johnharveybc/Robert-roving-robot/Report/Robot Pictures/Chassis Front.jpg

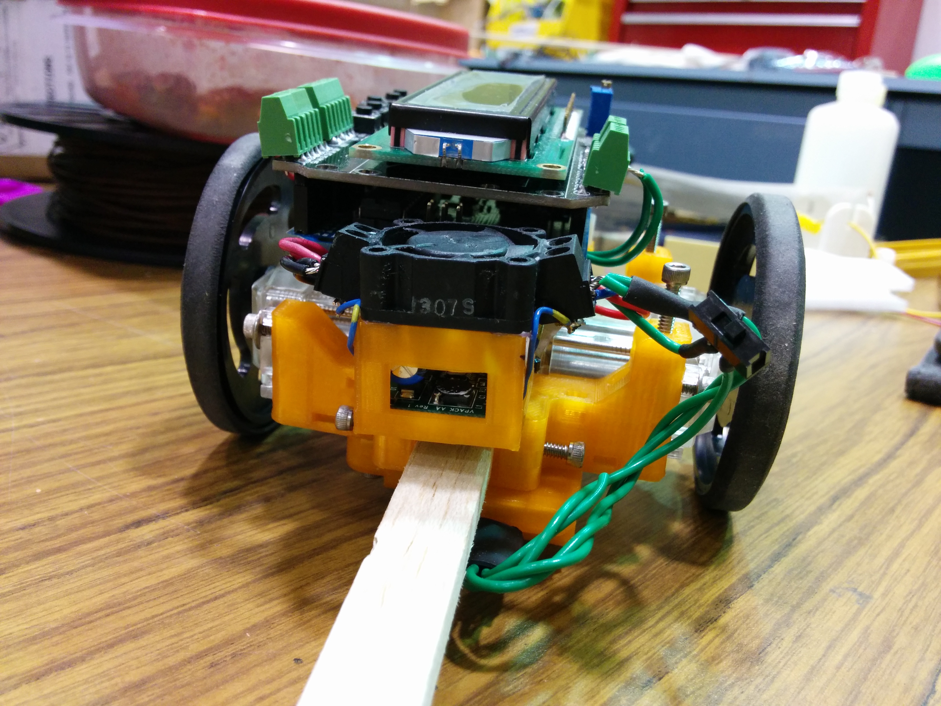
Report/Robot Pictures/Chassis Front.jpg
