johnharveybc/Robert-roving-robot/Report/Robot Pictures/Inductors.jpg

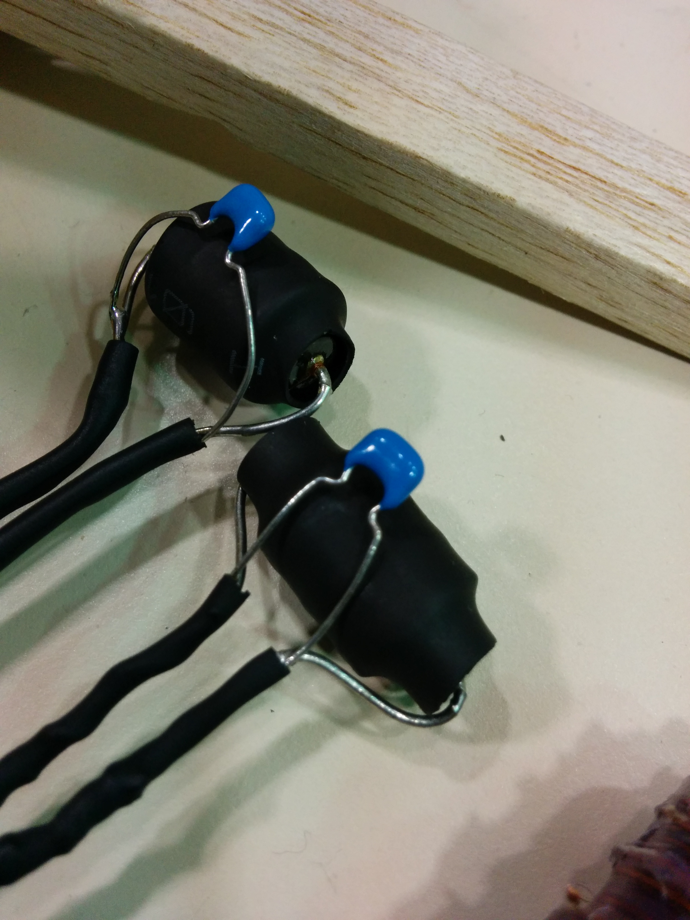
Report/Robot Pictures/Inductors.jpg
