johnharveybc/Robert-roving-robot/README.md

Robert-roving-robot
===================

EECE 284 January-April 2014
