johnharveybc/Robert-roving-robot/Report/EECE 284 report.docx

EECE 284: Electronics Laboratory

Project Report for Fast Orange—an Electromagnetic Track Rover

John Harvey, 29240116 (25%)

Liam Hodgson, 29154119 (25%)

Scott Lawson, 34359117 (25%)

Rowan Walsh, 30817118 (25%)

March 31st, 2014

Course taught by Dr. Jesús Calviño-Fraga, P. Eng

# 1.0—Introduction

Our project for EECE 284 was an Arduino-based rover, designed to follow a sinusoidal, 15.175 kHz electromagnetic signal. The format of the course was a time trial: each group’s robot completed a circuit of a racetrack. The runs were timed, and after each group’s entry attempted the course, the robot with the fastest time was awarded the highest mark.

The signal the robot was to follow was generated by running a 20V peak-to-peak 15.175 kHz sinusoidal voltage through a wire. The wire was embedded in the competition surface, creating the path the robots were to follow. In addition to straight track, signals were placed along the track, indicating the beginning and end of the path, as well as the direction to turn at the intersection of wires. Bridges were another feature of the track, which added an extra challenge, as robots could not vary their path too greatly while on the bridge, for risk of falling off, and as the depth of the wire from the surface was greater on the bridges.

The robot followed the racecourse by detecting the electromagnetic field generated by the wire, using inductors mounted at the front of the robot. These signals were put through peak-detection and amplification circuits, and then fed into a PID algorithm. The outputs of the PID algorithm drove MOSFET motor drivers, allowing the robot to follow the wire and racecourse with a high degree of accuracy.

## 1.1—Mechanical

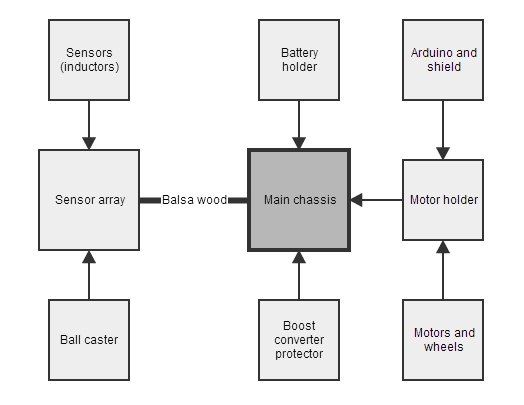
[picture p3: figure]

The chassis, the main mechanical component of the robot, was designed to minimize mass and structurally incorporate as many essential components (microcontroller, motors, battery) as possible. The robot consisted of three sections: the main chassis, sensor array, and a piece of balsa wood which joined the two. The front chassis and sensor array were 3D printed in bright orange poly-lactic acid (PLA), to minimize mass, and in homage to the industrial-strength, orange-scented hand cleaner, Fast Orange.

Figure 1: Mechanical block diagram

The main chassis consisted of three components: a battery holder, boost-converter protector, and motor holder. The battery used fit neatly under the robot, as it was flat and thin. Four short wires extended from the battery holder to the boost-converter protector, mounted at the front of the main chassis. Wires carrying 5 and 10 volts left the boost converter, carrying power to the Arduino Uno and motors, respectively. A shield incorporating an LCD monitor, potentiometers, several screw-terminal ports, and six buttons sat atop the Arduino Uno, which was mounted on the motor holder. Unsurprisingly, the motor holder held the motors. The other components (boost-converter protector, battery holder, balsa wood) were attached to the motor holder.

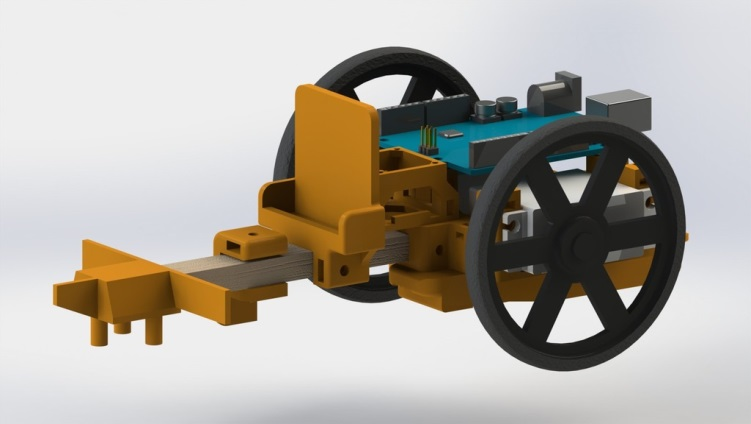
[picture p4: figure]

The sensor array held a Tamiya 70144 ball caster and three inductors—two perpendicular to the direction of motion of the robot, one parallel, and all mounted close to the ground. The balsa wood was firmly inserted in the sensor array, holding it in front of the main chassis.

Figure 2: A Solidworks render of the rover. Not pictured: sensors, ball caster, shield, or amplifier circuits.

Various nuts, bolts, plastic spacers, and some hot glue held the components together.

## 1.2—Electrical

### 1.2.1—Power supply

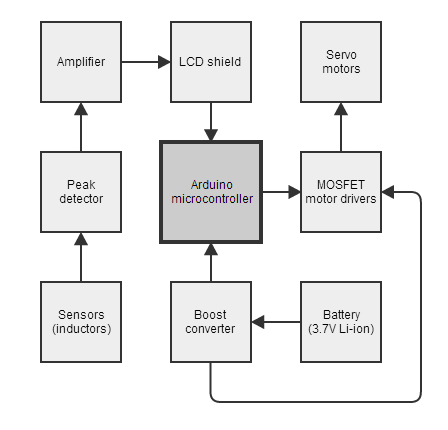
[picture p5: figure]

The choice of power supply for our robot was important, as a higher voltage would allow us to run the motors at a higher RPM, and a larger capacity would allow for longer testing time. The battery chosen, a rechargeable lithium ion battery with a voltage of 3.7 volts and a capacity of 950 mAh [1] was taken from an old cellphone. Quick to recharge and lightweight, the battery fell well below the limit set for this competition. To provide an appropriate voltage for the Arduino and motors, a DC-DC boost converter was used, allowing us to supply 10V to the motors, and 5V to the Arduino, without surpassing the maximum battery voltage of 6V. An appropriate choice of battery to work with the boost converter was important: a battery with an extremely low internal resistance had to be used to supply sufficient current to the converter, ruling out traditional alkaline batteries. Additionally, by using a boost converter, we were able to ensure that the motor voltage did not fluctuate as the battery drained, allowing for more repeatability in testing.

Figure 3: Electrical block diagram

The converter used was a VPack PBC [2] based on an LM2623MM DC/DC boost converter, modified to supply ten and five volts. Said modification consisted of de-soldering and replacing a pair of surface-mount resistors and capacitors. The battery came from an LG Rumour 2.

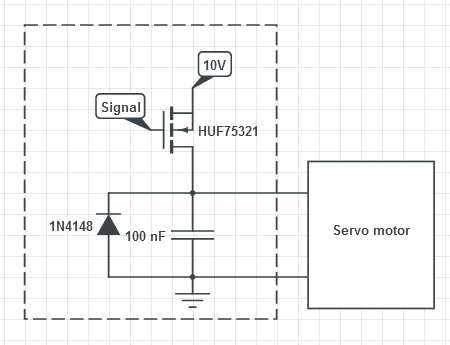
[picture p6: figure]

### 1.2.2—Motor control

Figure 4: MOSFET motor controller

The two Solarbotics GM4 servos provided the driving force for the robot, and were controlled via MOSFET drivers. The gate of the MOSFET was connected to the PWM output of the Arduino, and the source and drain were connected to the 10V supplied by the boost converter and the motor, respectively. A diode and capacitor were used with the motor controller to prevent flyback current and serve as a decoupling capacitor.

### 1.2.3—Sensor array

The robot was to follow a path defined by a buried wire carrying a 20V peak-to-peak signal at 15.175 kHz. This magnetic field produced by the wire was detected by two 100mH inductors. By placing appropriately-sized capacitors ( C=1/4π^2 f^2 L ) in parallel with the inductors, the sensors could be tuned to a resonant frequency equal to that of the desired field. 1nF capacitors were selected, producing a resonant frequency of 15.9kHz, which was sufficiently close to the desired frequency to be effective.

Two inductors were mounted perpendicular to the direction of motion, to provide relative signal strength, indicating whether the robot was to the left or right of the path. One inductor was mounted parallel to the direction of motion, to detect wire perpendicular to the track, indicating the start, end, and turn warnings on the track. These inductors were mounted closer to the bulk of the robot than the other sensors—the further away the perpendicular sensors were from the main chassis, the more sensitive they would be to small changes in the angle of the robot. By placing the parallel sensor close to the main chassis, turns could be detected later, reducing the delay between detection of a turn and the turn itself.

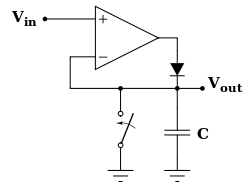
[picture p7: figure]

The AC signal induced in the inductor was then converted to DC via a peak detector, and amplified by a fixed-gain amplifier with a gain of approximately x20. The structure of the peak detector was a BJT (acting as a switch) connected to a digital output port, wired in parallel with a capacitor. A diode rectified the input voltage, which charged the capacitor to the peak voltage of the signal. This voltage was read by one of the digital inputs on the Arduino. After reading, the gate of the BJT shorts to ground, discharging the capacitor and restarting the process. A non-inverting amplifier circuit, consisting of an op-amp and several resistors, was used to provide variable gain.

Figure 5: Peak-detector circuit diagram

### 1.2.4—Microcontroller

An Arduino UNO microcontroller was chosen for the controller of our robot, as team members were more familiar with it than the provided microcontroller. Sufficiently powerful, reasonably inexpensive, and with a wealth of libraries, the Arduino read the sensors, controlled the motors voltage, displayed information on the LCD, and ran the PID algorithm on the sensor inputs. The Arduino was never directly interfaced with: all inputs and outputs went through a shield.

### 1.2.5—LCD shield

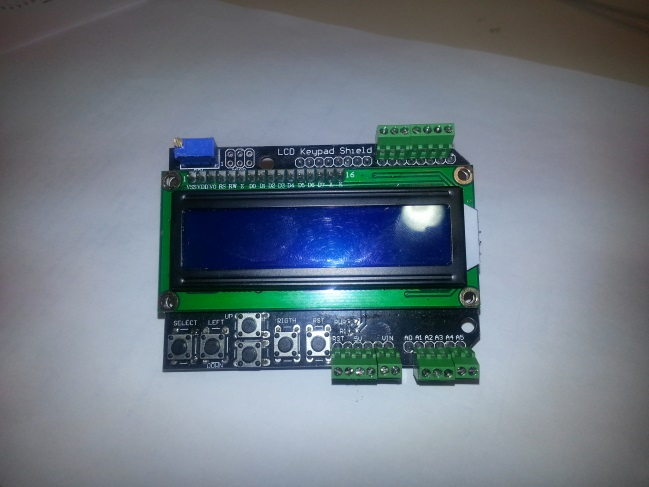
[picture p8: figure]

An LCD shield [3] incorporating several buttons and a potentiometer was used to provide an easy interface for debugging and tuning the robot. Menus were navigated and software parameters (PID gain values, turn time, etc.) could be adjusted via the buttons. While the robot was running the course, the LCD displayed the battery voltage, time since beginning the run, and whether or not the robot had detected a turn. The screw-terminals on the shield proved very useful for making quick adjustments to circuitry and wiring.

Figure 6: The LCD shield

## 1.3—Software

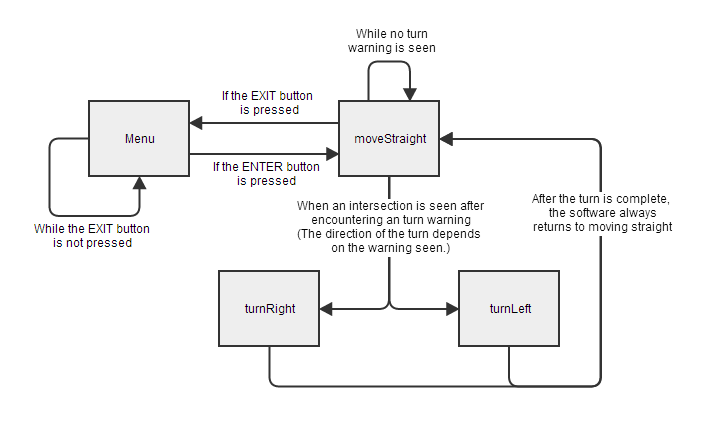
[picture p9: figure]

The robot's behaviour was coded as a loop with a simple state-space. In any distinct loop, the robot was in one of four states: Menu, MoveStraight, TurnRight, and TurnLeft. From the MoveStraight state, the Menu state was entered if the menu-entry button was pressed; likewise the Menu state could be exited to the MoveStraight state if the menu-exit button was pressed. The Menu state allowed the programming of various calibration values used by the robot: constants for the PID control, triggers and cut-offs, speeds, etc. The MoveStraight state was the main running state of the robot. Every loop in this state the sensors were read and fed to the PID control, which in turn controlled the PWM signals sent to the motors. The MoveStraight state also kept track of lap timing and intersection/signal counting. After encountering 2 or 3 closely-spaced intersections (which indicates an upcoming left or right turn), the intersection-handling block would change a flag on so that on the next intersection detection the robot would switch to the TurnLeft or TurnRight state. After executing either of the Turn states, the robot would return to MoveStraight, with the upcoming turn flag turned back off.

1.3.1—PID control
A PID (proportional, integral and derivative gain) control system was implemented to control the motion of the robot due to its simplicity. The difference between the two main inductors was used as the input error on which the PID gains were applied. To keep the speed of the robot high, the motor control was 'subtractive': both motors were run at the set maximum speed, with the PID algorithm's output subtracted from one of the motor's speeds instead of added. The sign of the output determined which motor was slowed to effect the correction.
We found that derivative gain had little to no effect on the robot's performance, likely because of the low speeds used. Higher integral gains prevented the robot from 'falling off' while turning tight corners and prevented any steady-state errors on straight sections of the track. The running integral 'sum' of past errors was capped and also reset whenever the robot turned at an intersection.

1.3.2—Signals and intersections
The value of the center, intersection, inductor is read every loop while the robot is in the moveStraight state. The analog value read by the sensor circuit is evaluated to a digital 'high' (intersection detected) or 'low' (no intersection detected) using a Schmitt trigger in order to give some hysteresis to the signal and prevent oscillations close to the cut-off voltage. A Schmitt trigger has both a high-cut-off and low-cut-off such that Vhigh>Vlow. In order for the sensor's state to go high, its analog reading must exceed Vhigh; while for it to go low, its value must fall below Vlow. If the difference between the two cut-offs exceeds the typical noise from the sensor, then this trigger logic will act as a fairly stable rise-detector and provide an accurate count of the number of intersections passed.
As an intersection was passed, a running counter was incremented to indicate the number of recently-passed intersections. This counter has a timeout so that once the timeout is passed the count is stopped and used as the number of intersections in the recent turn signal 'block'. If this recent signal block had a count of just 1 (due to cross-talk from the main 'road' wire, etc.) it was ignored; counts of 2, 3, or 4 resulted in a flag to turn at the next intersection or stop the lap clock.

Figure 7: Software block diagram

# 2.0—Project analysis

## 2.1—Design analysis

While our robot performed well, several adjustments would be made if the project was undertaken again. Most importantly, the inductors would be more securely fastened. While it was easy to make fine adjustments to their positions, by bending the wires from which they hung, this created problems. The inductors were bumped around during transport of the robot, and in the occasional collision, which had dramatic effects on the robot’s ability to sense the line. Seemingly inconsequential adjustments proved to be the difference between successful and unsuccessful runs, and it was extremely difficult to quantify the adjustments made.

Using a cell phone battery was one of the better decisions made: in addition to allowing us to use a higher motor voltage, the size, ability to recharge, and weight proved advantageous. Teams, on average, went through 6-8 AA batteries. We used one battery, from an old cell phone, which was easier on the environment and pocketbook. We would likely reduce the motor voltage if the project was undertaken again: the robot ran at approximately a third of its top speed, as controlling the robot became extremely difficult after that point. A reduction in maximum speed would allow for more precise control over motor velocity.

Wire management became a concern later on in the project: last-minute additions lead to a large number of unruly wires, which came close to challenging the height requirements. Incorporating wire management into the chassis, or perhaps using piping in place of the balsa wood, and routing the wires through them, would be possibilities to explore.

One of the more successful debugging features incorporated were the ‘turn signals’. Two LEDs mounted near the front of the robot would blink before turns were initiated, allowing us to observe what the robot was sensing without having to observe whether or not it turned, and, on several occasions, allowing us to catch the robot before it turned off the table.

# 3.0—Conclusions

The robot ran very successfully—it completed the track without any human intervention with the fastest recorded time of any team: 1:09. By using a lighter battery and a 3D printed chassis, mass was significantly reduced, allowing for greater speed. Wiring became unruly as the project progressed, and the inductors were extremely vulnerable to changes in position—a small bump would result in unquantifiable motion of the inductors, changing the behaviour of the robot. Our choice of a rechargeable battery, with a DC-DC converter, ensured that the voltage the motors and Arduino saw would remain constant regardless of the charge level of the battery, increasing repeatability in testing.

The planning, design, coding, manufacture, and testing of the robot took approximately 100-120 hours in total. If the robot was to be constructed again, it is estimated that it would take no more than 20 hours—printing the parts, manufacturing the circuits, and adjusting the inductors would take the lion’s share of the time.

# References

If we referred to it in the body of the report (a book, website, source of information) we need to have the full citation here. The in-text citation should just be a number in square brackets, [n], and the references should look something like this:

[1] LG Electronics, “LG RUMOR 2 (LX265)”, http://www.lg.com/us/cell-phones/lg-LX265-Black-black-rumor-2

[2] Sparkfun Electronics, “5V DC to DC Step Up – Vpack PCB”, https://www.sparkfun.com/products/8290

[3] RobotShop Distribution Inc., “DFRobot LCD Keypad Shield for Arduino”, http://www.robotshop.com/en/dfrobot-lcd-keypad-shield-arduino.html

# Bibliography

Cockrill, C., “Understanding Schmitt Triggers”, September 2011, retrieved from http://www.ti.com/lit/an/scea046/scea046.pdf

Nave, R., “Resonant LRC Circuits”, December 2012, retrieved from http://hyperphysics.phy-astr.gsu.edu/hbase/electric/serres.html

Romani, M., “SimpleTimer – A timer library for Arduino”, 2010, retrieved from https://github.com/infomaniac50/SimpleTimer

Marziali, A. and Nakane, J., “ENPH 253 Labs and Lectures 2013”, May 2013, retrieved from http://projectlab.engphys.ubc.ca/coursearchive/enph253-2013/labslectures2013/

# Appendices

## Appendix 1: Code

#include <SimpleTimer.h> // Pre-built library

#include <LiquidCrystal.h> // Pre-built library

#include <EEPROM.h> // Pre-built library

LiquidCrystal lcd(8, 9, 4, 5, 6, 7);

// Configuration

#define SUBTRACTIVE_MOTOR_SPEED // Comment for additive and subtractive motor speed

#define CALCULATE_DERIVATIVE_ERROR // Comment to remove derivative gain from error calculations

#define CALCULATE_INTEGRAL_ERROR // Comment to remove integral gain from error calculations

#define CALCULATE_ANALOG_PID // Comment to calculate PID error using boolean logic instead

// of analog values

#define USE_SMART_INTERSECTIONS // Comment to use the intersection map instead of sensing intersection signals

//#define DEBUG_MODE // Comment to display voltage and time instead of debug

// values

// Pin definitions

#define LEFT_SENSOR 1 // ANALOG

#define RIGHT_SENSOR 2 // ANALOG

#define CENTER_SENSOR 3 // ANALOG

#define BATTERY_SENSOR 4 // ANALOG

#define BUTTON_INPUT 0 // ANALOG

#define LEFT_MOTOR 11 // PWM

#define RIGHT_MOTOR 3 // PWM

#define SENSOR_RESET 2 // DIGITAL

#define LEFT_TURN_LED 12 // DIGITAL

#define RIGHT_TURN_LED 13 // DIGITAL

// Keypad button definitions

#define RIGHT 0

#define UP 1

#define DOWN 2

#define LEFT 3

#define SELECT 4

#define NONE 5

// LCD cursor definitions

#define TOP 0

#define BOTTOM 1

// Wire States

#define TOO_LEFT -1

#define TOO_RIGHT 1

#define OFF_WIRE 5

// Turn indicator LEDs

SimpleTimer turnSignalTimer;

bool turnSignalState = false;

// "Clock" speed

unsigned long loopPeriod;

unsigned long lastLoop;

enum state

{

menu,

moveStraight,

turnLeft,

turnRight

};

struct Parameter

{

String Name;

byte Value;

int Index;

};

// Prevents LCD flicker

short lcdRefreshCount = 0;

short lcdRefreshPeriod = 200;

// Prevents excess battery readings

short batteryCount = 0;

short batteryPeriod = 10000;

volatile float batteryVoltage = 0.0;

// Sensors

volatile short left = 0;

volatile short right = 0;

volatile short leftDetected = false;

volatile short rightDetected = false;

// Smart intersection detection

#define INTERSECTION_COUNT_LEFT 2

#define INTERSECTION_COUNT_RIGHT 3

#define INTERSECTION_COUNT_ORIGIN 4

volatile short center = 0;

volatile short centerOldHigh = false;

volatile short intersectionSignalRecent = 0;

volatile short centerTimeoutCount = 0;

volatile short intersectionTurnFlag = 0;

// Mapped intersection detection

enum intersectionCommand

{

straight,

leftTurn,

rightTurn,

stop

};

int intersections[] =

{

straight,

straight,

straight,

straight,

straight,

leftTurn,

straight,

straight,

rightTurn,

straight,

straight,

};

#define INTERSECTION_COUNT (sizeof(intersections)/sizeof(int)) // MUST EQUAL NUMBER OF PARAMETERS

int intersectionIndex = -1;

volatile int centerNew = false;

volatile int centerRisingEdge = false;

volatile int centerHighDetected = false;

volatile int centerLowDetected = false;

// Control

float proportional = 0.0;

float integral = 0.0;

float derivative = 0.0;

short derivativeCounter = 0;

short integralOffsetPeriod = 50;

short integralOffsetCounter = integralOffsetPeriod;

float error = 0.0;

float previousError = 0.0;

// State tracking

state currentState = menu;

short menuIndex = 0;

// Clock

volatile unsigned int clockTime = 0;

volatile int clockRun = false;

volatile unsigned int clockStart = 0;

// EEPROM values

Parameter proportionalGain = {"P-gain", 0, 1};

Parameter integralGain = {"I-gain", 0, 2};

Parameter derivativeGain = {"D-gain", 0, 3};

Parameter speed = {"Speed", 0, 4};

Parameter thresholdLeft = {"L-Thresh", 0, 5};

Parameter thresholdRight = {"R-Thresh", 0, 6};

Parameter centerSchmittHigh = {"C-Schmitt H", 0, 7};

Parameter centerSchmittLow = {"C-Schmitt L", 0, 8};

Parameter integralCap = {"I-Cap", 0, 9};

Parameter centerTimeoutLimit = {"Timeout", 0, 10};

// Make sure any EEPROM value is added to the array

Parameter *parameters[] =

{

&proportionalGain, &integralGain, &derivativeGain,

&speed, &thresholdLeft, &thresholdRight, &centerSchmittHigh,

&centerSchmittLow, &integralCap, &centerTimeoutLimit

};

#define PARAMETER_COUNT (sizeof(parameters)/sizeof(Parameter*)) // MUST EQUAL NUMBER OF

// PARAMETERS

inline void TurnSignal()

{

if (intersectionTurnFlag == INTERSECTION_COUNT_LEFT)

{

digitalWrite(LEFT_TURN_LED, turnSignalState);

digitalWrite(RIGHT_TURN_LED, 0);

}

else if (intersectionTurnFlag == INTERSECTION_COUNT_RIGHT)

{

digitalWrite(LEFT_TURN_LED, 0);

digitalWrite(RIGHT_TURN_LED, turnSignalState);

}

else

{

digitalWrite(LEFT_TURN_LED, 0);

digitalWrite(RIGHT_TURN_LED, 0);

}

turnSignalState = !turnSignalState;

}

// Clears the LCD screen

inline void Clear()

{

lcd.clear();

}

// Prints a string to the LCD display, with an optional integer value beside it

inline void Print(String text, int value = -1)

{

lcd.print(text);

if (value != -1) lcd.print(value);

}

// Changes the LCD cursor location

inline void Cursor(int row, int column)

{

lcd.setCursor(column, row);

}

// SETUP

void setup()

{

// For algorithm speed checking

loopPeriod = 0;

lastLoop = micros();

// Initialize LCD

lcd.begin(16, 2);

lcd.setCursor(0,0);

pinMode(SENSOR_RESET, OUTPUT);

// Turn signals

pinMode(LEFT_TURN_LED, OUTPUT);

pinMode(RIGHT_TURN_LED, OUTPUT);

digitalWrite(LEFT_TURN_LED, 0);

digitalWrite(RIGHT_TURN_LED, 0);

turnSignalTimer.setInterval(100, TurnSignal);

// Force motors off by default

MotorSpeed(LEFT_MOTOR, 0);

MotorSpeed(RIGHT_MOTOR, 0);

// Parameters need to be loaded from EEPROM

LoadFromEEPROM();

// Intro text

Clear();

Cursor(TOP, 0);

Print("FAST ORANGE");

Cursor(BOTTOM, 0);

#ifdef DEBUG_MODE

Print("Debug Mode");

#else

Print("Race Mode");

#endif

delay(1000);

currentState = menu;

ClockReset();

}

// LOOP

void loop()

{

switch(currentState)

{

case menu:

MotorSpeed(LEFT_MOTOR, 0);

MotorSpeed(RIGHT_MOTOR, 0);

ShowMenu();

break;

case moveStraight:

Update();

#ifdef CALCULATE_ANALOG_PID

ProcessMovementAnalog();

#else

ProcessMovementDigital();

#endif

break;

case turnLeft:

case turnRight:

Turn();

break;

}

turnSignalTimer.run();

loopPeriod = micros() - lastLoop;

lastLoop = micros();

}

// Drains the capacitors on the peak detector so that can be read again

inline void SensorReset(int microseconds = 15)

{

digitalWrite(SENSOR_RESET, HIGH);

delayMicroseconds(microseconds);

digitalWrite(SENSOR_RESET, LOW);

}

// Returns the current button being pressed.

// Can detect one button being pressed at a time.

inline int ReadButton()

{

int value = analogRead(BUTTON_INPUT);

if (value > 1000) return NONE;

if (value < 50) return RIGHT;

if (value < 250) return UP;

if (value < 450) return DOWN;

if (value < 650) return LEFT;

if (value < 850) return SELECT;

return NONE;

}

// Variables used to modify rate of change of values in menu

int previousButton = UP;

int holdCounter = 0;

// Display the menu on screen

void ShowMenu()

{

// Show menu item on top row

Clear();

Cursor(TOP, 0);

Print(parameters[menuIndex]->Name);

Print(" ", parameters[menuIndex]->Value);

// Show sensor info on bottom row. Useful for threshold calibration

Cursor(BOTTOM, 0);

Print(" ", analogRead(LEFT_SENSOR));

Print(" ", analogRead(RIGHT_SENSOR));

Print(" ", analogRead(CENTER_SENSOR));

SensorReset();

switch(ReadButton())

{

case UP: // Increase item value

holdCounter = (previousButton == UP) ? (holdCounter + 1) : 0;

previousButton = UP;

parameters[menuIndex]->Value += 1 + (holdCounter / 20);

break;

case DOWN: // Lower item value

holdCounter = (previousButton == DOWN) ? (holdCounter + 1) : 0;

previousButton = DOWN;

parameters[menuIndex]->Value -= (1 + (holdCounter / 20));

break;

case LEFT: // Next menu item

menuIndex = (menuIndex > 0) ? (menuIndex - 1) : (PARAMETER_COUNT - 1);

break;

case RIGHT: // Previous menu item

menuIndex = (menuIndex < PARAMETER_COUNT - 1) ? (menuIndex + 1) : 0;

break;

case SELECT:// Exit menu

delay(500);

if (ReadButton() == SELECT)

{

Clear();

Cursor(TOP, 0);

Print("Exiting menu");

SaveToEEPROM(); // Save values to EEPROM before exiting

delay(750);

currentState = moveStraight;

intersectionTurnFlag = 0;

//ClockToggle();

Clear();

return;

}

break;

}

delay(150);

}

// Loads all values from the EEPROM

void LoadFromEEPROM()

{

for(int i = 0; i < PARAMETER_COUNT; i++)

parameters[i]->Value = EEPROM.read(parameters[i]->Index);

}

// Saves all values to the EEPROM

void SaveToEEPROM()

{

for(int i = 0; i < PARAMETER_COUNT; i++)

EEPROM.write(parameters[i]->Index, parameters[i]->Value);

}

inline void DisplaySensorValues()

{

if(lcdRefreshCount == 0) // Mitigates screen flicker and time consuming operations

{

#ifdef DEBUG_MODE

// Sensors on top line

Cursor(BOTTOM, 0);

#ifdef USE_SMART_INTERSECTIONS

Print("Signal: ", intersectionTurnFlag);

#else

Print("Intersection: ", intersectionIndex + 1);

#endif

#else

Cursor(TOP, 0); Print(" "); Cursor(TOP, 0);

Print("Time: "); lcd.print(Clock()/1000.0); Print("s");

#endif

}

#ifndef DEBUG_MODE

if(batteryCount == 0)

{

Cursor(BOTTOM, 0);

batteryVoltage = float(analogRead(BATTERY_SENSOR)) / 1024.0 * 5.0;

Print("Battery: "); lcd.print(batteryVoltage); Print("V");

}

#endif

}

inline void CenterMapUpdate()

{

center = analogRead(CENTER_SENSOR);

centerHighDetected = center > centerSchmittHigh.Value;

centerLowDetected = center > centerSchmittLow.Value;

if(!centerLowDetected)

{

centerNew = true;

}

if(centerNew && centerHighDetected)

{

delay(50);

if (analogRead(CENTER_SENSOR) > centerSchmittHigh.Value)

{

centerRisingEdge = true;

delay(50);

centerNew = false;

intersectionIndex++;

if (intersectionIndex == INTERSECTION_COUNT)

intersectionIndex = 0;

switch(intersections[intersectionIndex])

{

case straight:

currentState = moveStraight;

break;

case leftTurn:

currentState = turnLeft;

break;

case rightTurn:

currentState = turnRight;

break;

}

}

}

}

inline void CenterSmartUpdate()

{

center = analogRead(CENTER_SENSOR);

if (centerTimeoutCount)

centerTimeoutCount += 1;

if (!centerOldHigh && (center > centerSchmittHigh.Value)) // On switch-to-high

{

centerOldHigh = true; // Switch current center state to high

if((intersectionSignalRecent + 1) == INTERSECTION_COUNT_ORIGIN)

// If the start/stop signal is encountered, toggle clock.

// This is done on when it switches high (instead of waiting for timeout) to save a bit // of clock-time.

{

ClockToggle();

}

switch(intersectionTurnFlag)

{

case INTERSECTION_COUNT_LEFT: // First intersection after left signal

currentState = turnLeft;

break;

case INTERSECTION_COUNT_RIGHT: // First intersection after right signal

currentState = turnRight;

break;

default: // Else

currentState = moveStraight;

intersectionSignalRecent += 1;

break;

}

centerTimeoutCount = 0; // Stop timeout counter

intersectionTurnFlag = 0; // Reset flag

}

else if (centerOldHigh && (center < centerSchmittLow.Value)) // On switch-to-low

{

centerOldHigh = false; // Swtich current center state to low

centerTimeoutCount = 1; // Start timeout counter

}

if (centerTimeoutCount >= (centerTimeoutLimit.Value * 2)) // Timeout

{

if (intersectionTurnFlag < intersectionSignalRecent)

// Do not let false signals effect the flag

intersectionTurnFlag = intersectionSignalRecent; // Set flag

intersectionSignalRecent = 0; // Reset signal counter

centerTimeoutCount = 0; // Stop timeout counter

}

}

// Updates the sensors and machine state

void Update()

{

if ((lcdRefreshCount == 0) && (currentState != menu) && (ReadButton() == SELECT))

{

delay(750);

if(ReadButton() == SELECT) // debounce MENU button

{

// Stop motors before entering menu

MotorSpeed(LEFT_MOTOR, 0);

MotorSpeed(RIGHT_MOTOR, 0);

Clear();

Cursor(TOP, 0);

Print("Entering menu");

currentState = menu;

delay(1000);

ClockReset();

}

}

// Read raw sensor values

left = analogRead(LEFT_SENSOR);

right = analogRead(RIGHT_SENSOR);

leftDetected = left > thresholdLeft.Value;

rightDetected = right > thresholdRight.Value;

if (leftDetected || rightDetected)

{

#ifdef USE_SMART_INTERSECTIONS

CenterSmartUpdate();

#else

CenterMapUpdate();

#endif

}

SensorReset(); // Drain capacitor in preparation for next sensor reading

// Display values on LCD

lcdRefreshCount = (lcdRefreshCount <= 0) ? lcdRefreshPeriod : (lcdRefreshCount - 1);

batteryCount = (batteryCount <= 0) ? batteryPeriod : (batteryCount - 1);

DisplaySensorValues();

}

// Calculates PID values for a single iteration of movement

void ProcessMovementDigital()

{

if (leftDetected && rightDetected) error = 0; // No error if both sensors see the wire

else if (!leftDetected && rightDetected) error = TOO_LEFT;

else if (leftDetected && !rightDetected) error = TOO_RIGHT;

else if (!leftDetected && !rightDetected) error = (previousError <= TOO_LEFT) ? -OFF_WIRE : OFF_WIRE;

// Proportional

proportional = error * float(proportionalGain.Value);

// Integral

#ifdef CALCULATE_INTEGRAL_ERROR

if (integralOffsetCounter < 0)

{

integral += (error * integralGain.Value);

integralOffsetCounter = integralOffsetPeriod;

}

else

{

integralOffsetCounter--;

}

if (integral > integralCap.Value)

integral = integralCap.Value;

else if (integral < -integralCap.Value)

integral = -integralCap.Value;

#else

integral = 0;

#endif

// Derivative

#ifdef CALCULATE_DERIVATIVE_ERROR

derivative = (error - previousError) / float(derivativeCounter) * float(derivativeGain.Value);

#else

derivative = 0;

#endif

int baseSpeed = (speed.Value * 4.0);

int mLeft = baseSpeed + (proportional + derivative + integral);

int mRight = baseSpeed - (proportional + derivative + integral);

#ifdef SUBTRACTIVE_MOTOR_SPEED

if (mLeft > mRight)

mLeft = baseSpeed;

else

mRight = baseSpeed;

#endif

MotorSpeed(LEFT_MOTOR, mLeft);

MotorSpeed(RIGHT_MOTOR, mRight);

if(previousError != error)

{

previousError = error;

derivativeCounter = 1;

}

else derivativeCounter++;

}

void ProcessMovementAnalog()

{

if (!leftDetected && !rightDetected) error = (previousError <= 0) ? -500 : 500;

else error = float(left) - float(right);

// Proportional

proportional = error * float(proportionalGain.Value);

derivative = (error - previousError) * float(derivativeGain.Value) / 50.0;

integral += (error * float(integralGain.Value)) / 50.0;

if (integral > integralCap.Value)

integral = integralCap.Value;

else if (integral < -integralCap.Value)

integral = -integralCap.Value;

#ifndef CALCULATE_INTEGRAL_ERROR

integral = 0;

#endif;

#ifndef CALCULATE_DERIVATIVE_ERROR

derivative = 0;

#endif;

int baseSpeed = (speed.Value * 4.0);

int mLeft = baseSpeed + (proportional + derivative + integral);

int mRight = baseSpeed - (proportional + derivative + integral);

#ifdef SUBTRACTIVE_MOTOR_SPEED

if (mLeft > mRight)

mLeft = baseSpeed;

else

mRight = baseSpeed;

#endif

MotorSpeed(LEFT_MOTOR, mLeft);

MotorSpeed(RIGHT_MOTOR, mRight);

}

// Modifies the motor speed given a value between 0 and 100

inline void MotorSpeed(int motor, int speed)

{

if (speed > 1000) speed = 1000;

else if (speed < 0) speed = 0;

analogWrite(motor, speed/4.0);

}

void Turn()

{

int direction;

if (currentState == turnLeft) direction = 1;

else if (currentState == turnRight) direction = -1;

else return;

Clear();

Print("TURN");

MotorSpeed(LEFT_MOTOR, 1000 * direction);

MotorSpeed(RIGHT_MOTOR, 1000 * -direction);

delay(700);

previousError = direction;

currentState = moveStraight;

Clear();

}

inline unsigned int Clock() // Displays the clock's current value (in milliseconds)

{

if (clockRun)

{

unsigned int currentMillis = millis();

clockTime += currentMillis - clockStart;

clockStart = currentMillis;

}

return clockTime;

}

inline void ClockToggle() // Toggles the clock to run or pause

{

if (clockRun) // If clock is currently running

{

clockTime += millis() - clockStart;

clockRun = false;

}

else

{

clockRun = true;

clockStart = millis();

}

}

inline void ClockReset() // Sets the clock to 0 and pauses the clock

{

clockTime = 0;

clockRun = false;

}

## Appendix 2: 3D printer files

Files in .stl format can be downloaded for all printed parts can be downloaded in .stl format at the following link. http://www.thingiverse.com/thing:290924
