johnharveybc/Robert-roving-robot/Report/HardwareFlowchart.docx

5V

Battery (3.7V LiPo)

Motors

MOSFETs

Boost converter

Arduino microcontroller

Magnetic field sensors

Peak Detector

Amplifier

LCD shield
