johnharveybc/Robert-roving-robot/Report/HardwareFlowchart.PNG

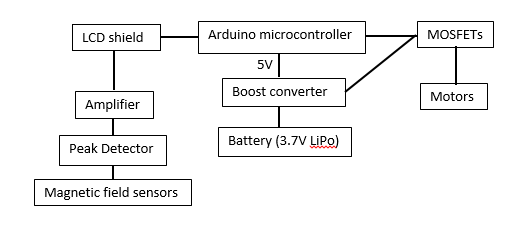
Report/HardwareFlowchart.PNG
