johnharveybc/Robert-roving-robot/Report/Robot Pictures/Chassis Rear.jpg

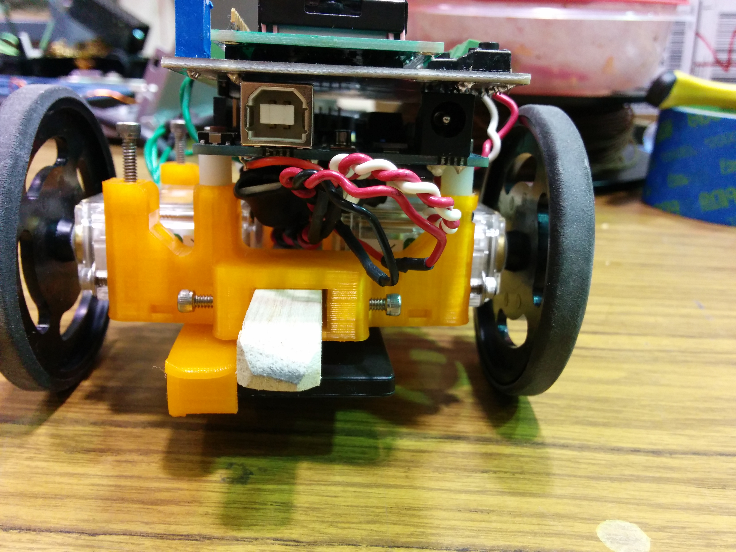
Report/Robot Pictures/Chassis Rear.jpg
