johnharveybc/Robert-roving-robot/Report/Robot Pictures/Partial Robot and Inductors.jpg

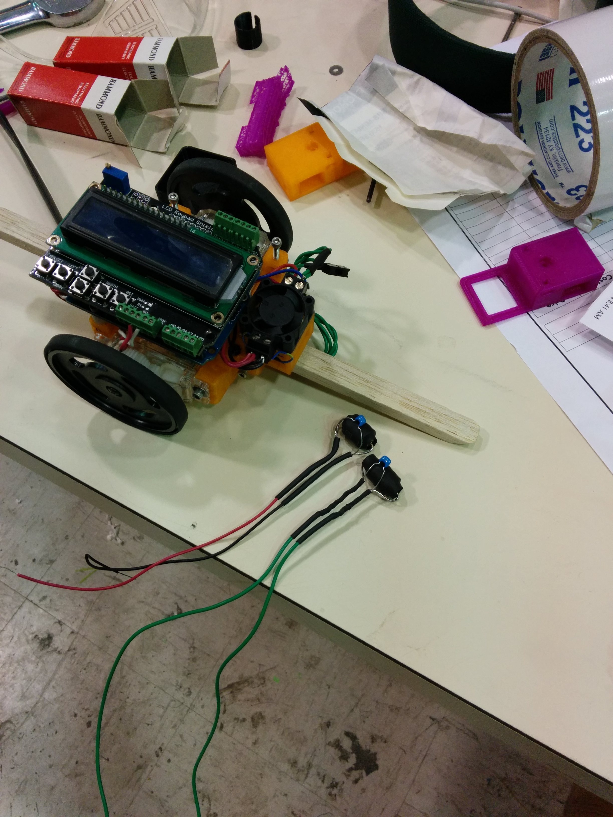
Report/Robot Pictures/Partial Robot and Inductors.jpg
