johnharveybc/Robert-roving-robot/Mechanical Stuff/Main Assembly.SLDASM

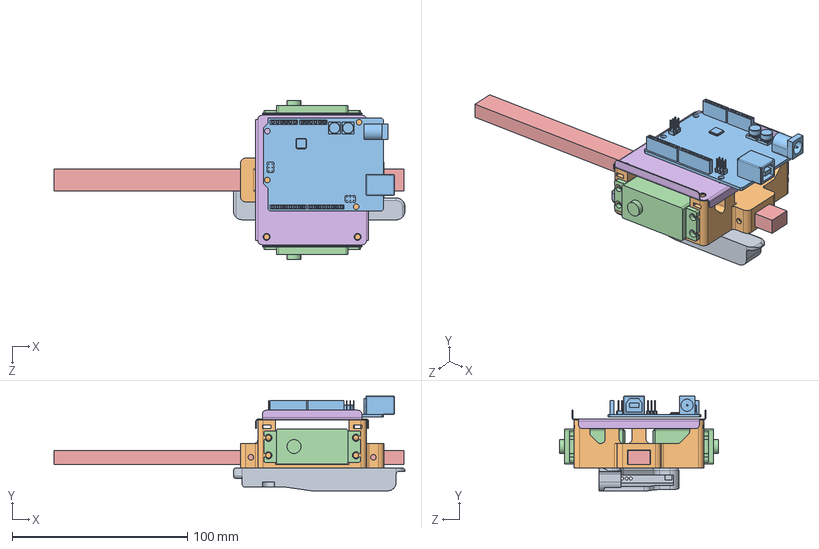
[picture p16: CAD file, 2014-03-09]
Mechanical Stuff/Main Assembly.SLDASM
200.5 x 54.2 x 91.0 mm
Battery Holder
Chassis
Arduino UNO
Motor x 2
Balsa Shaft
Shield Plate
