johnharveybc/Robert-roving-robot/Mechanical Stuff/Sensor head 3.SLDPRT

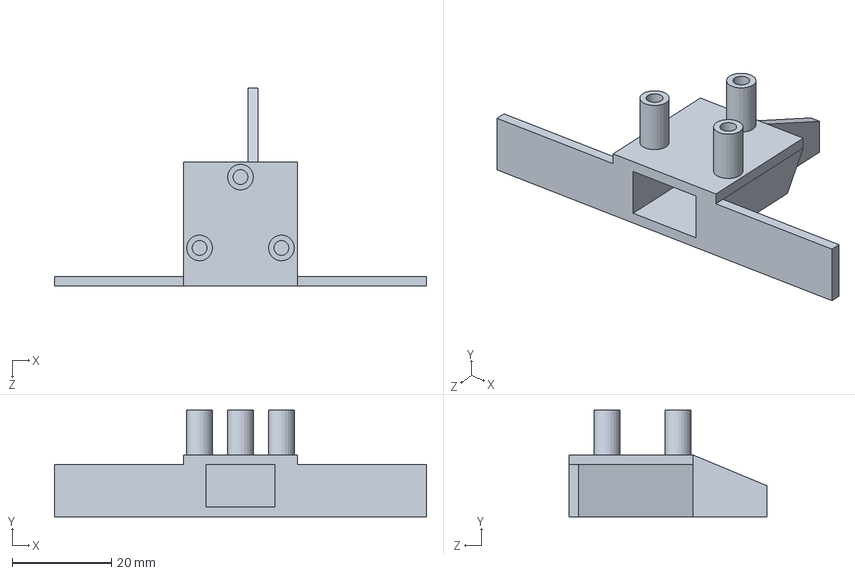
[picture p17: CAD file, 2014-03-28]
Mechanical Stuff/Sensor head 3.SLDPRT
75.0 x 21.5 x 40.0 mm
