johnharveybc/Robert-roving-robot/Mechanical Stuff/Centre Sensor Mount.SLDPRT

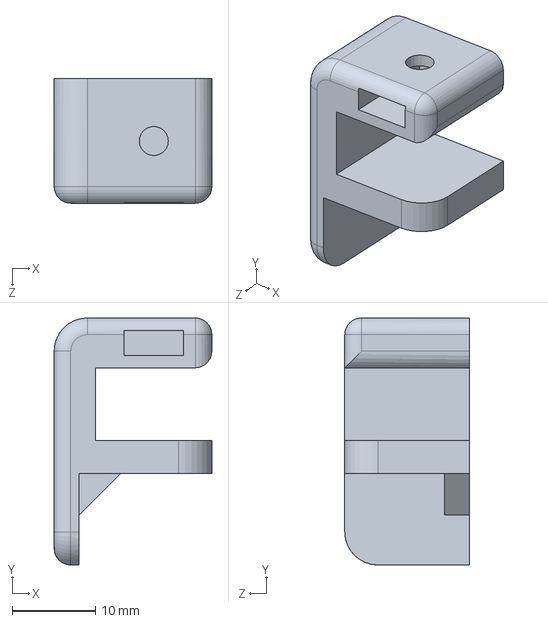
[picture p18: CAD file, 2014-03-28]
Mechanical Stuff/Centre Sensor Mount.SLDPRT
19.0 x 29.8 x 15.0 mm
