johnharveybc/Robert-roving-robot/Mechanical Stuff/Circuit Mount.SLDPRT

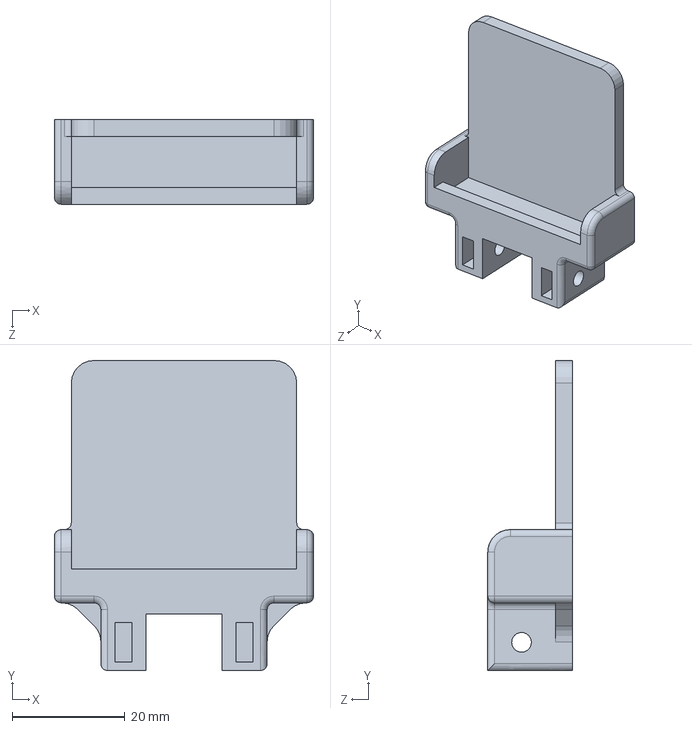
[picture p19: CAD file, 2014-03-28]
Mechanical Stuff/Circuit Mount.SLDPRT
46.0 x 55.0 x 15.0 mm
