johnharveybc/Robert-roving-robot/Mechanical Stuff/Chassis.SLDPRT

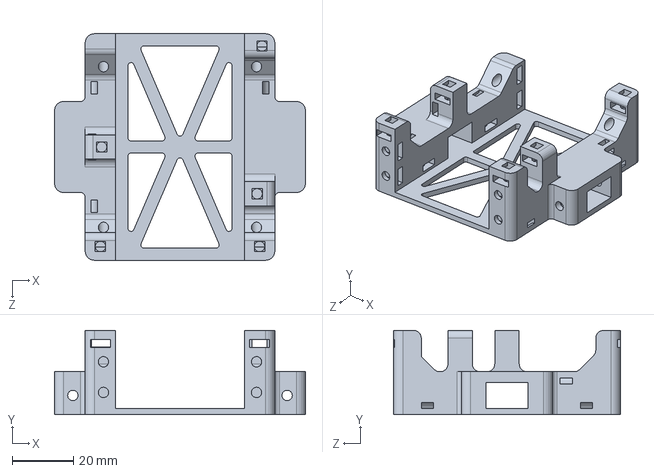
[picture p20: CAD file, 2014-03-13]
Mechanical Stuff/Chassis.SLDPRT
82.0 x 27.5 x 74.0 mm
