johnharveybc/Robert-roving-robot/Mechanical Stuff/Tolerances Test Part.SLDPRT

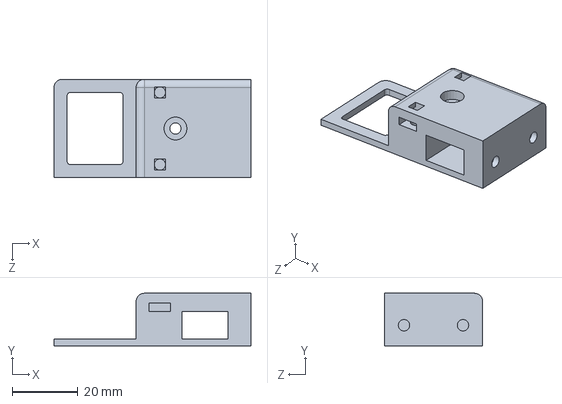
[picture p21: CAD file, 2014-03-13]
Mechanical Stuff/Tolerances Test Part.SLDPRT
60.0 x 16.0 x 30.0 mm
