johnharveybc/Robert-roving-robot/Mechanical Stuff/Sauce Case.SLDPRT

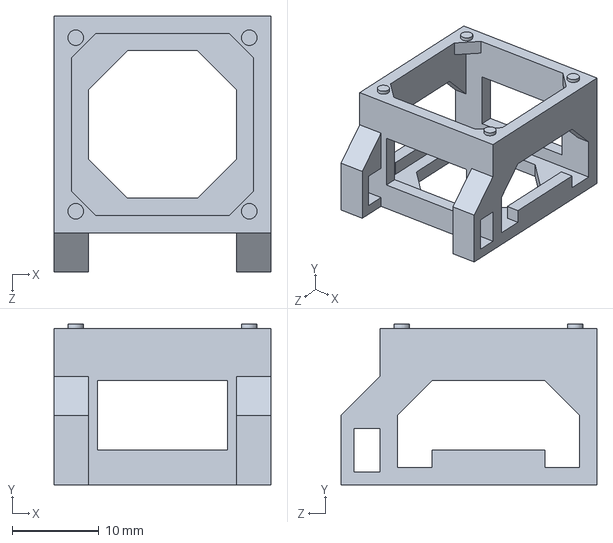
[picture p22: CAD file, 2014-03-13]
Mechanical Stuff/Sauce Case.SLDPRT
25.0 x 18.5 x 29.5 mm
