johnharveybc/Robert-roving-robot/Mechanical Stuff/Sensor Circuit Box.SLDPRT

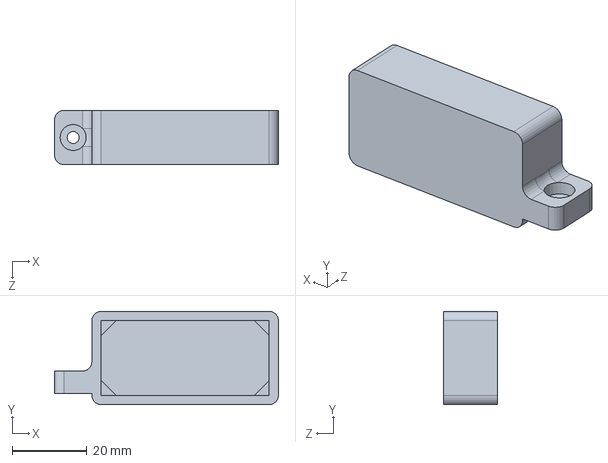
[picture p23: CAD file, 2014-03-09]
Mechanical Stuff/Sensor Circuit Box.SLDPRT
60.0 x 25.0 x 14.5 mm
