johnharveybc/Robert-roving-robot/Mechanical Stuff/Shield Plate.SLDPRT

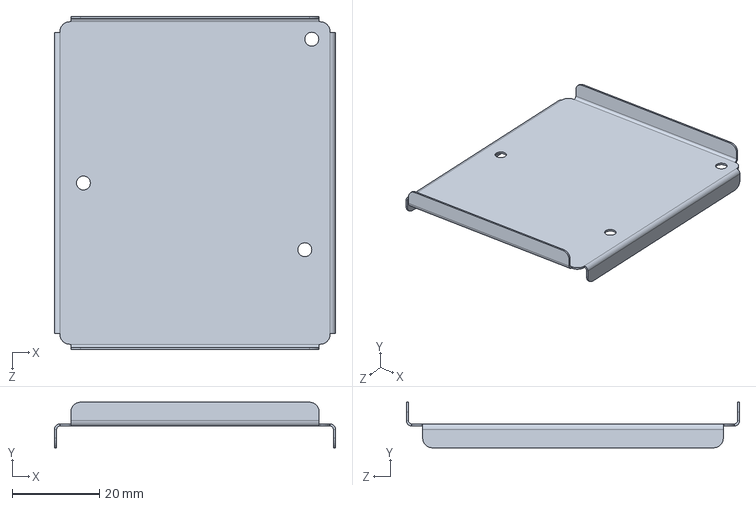
[picture p24: CAD file, 2014-03-09]
Mechanical Stuff/Shield Plate.SLDPRT
64.5 x 10.5 x 76.5 mm
