johnharveybc/Robert-roving-robot/Mechanical Stuff/Sensor Head.SLDPRT

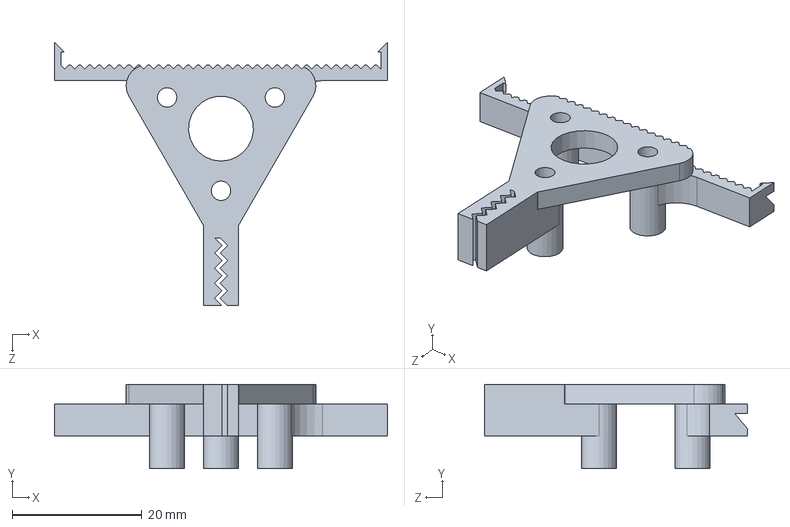
[picture p25: CAD file, 2014-03-05]
Mechanical Stuff/Sensor Head.SLDPRT
51.3 x 13.0 x 40.6 mm
