johnharveybc/Robert-roving-robot/Mechanical Stuff/Battery Holder.SLDPRT

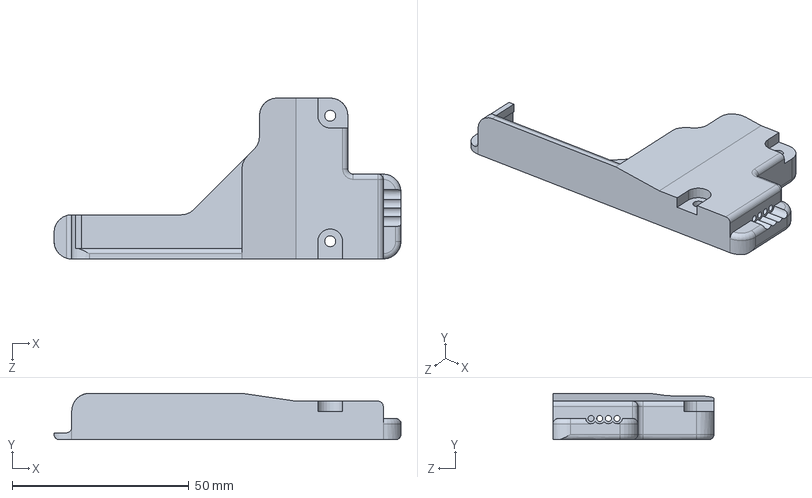
[picture p26: CAD file, 2014-02-28]
Mechanical Stuff/Battery Holder.SLDPRT
98.1 x 13.1 x 45.5 mm
