johnharveybc/Robert-roving-robot/Mechanical Stuff/Arduino UNO.SLDPRT

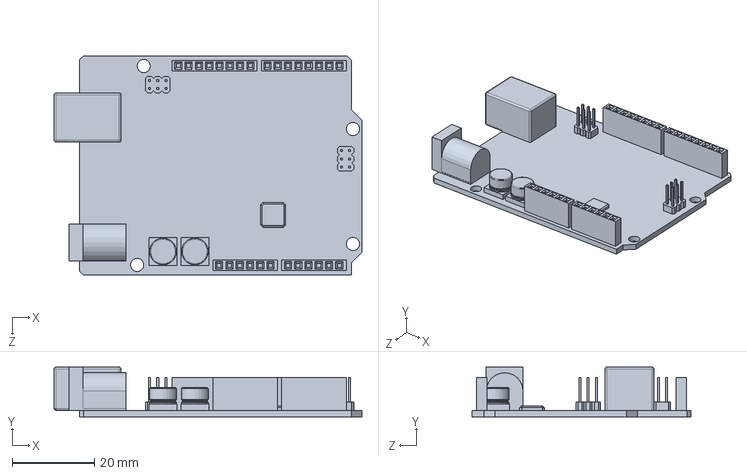
[picture p27: CAD file, 2014-02-28]
Mechanical Stuff/Arduino UNO.SLDPRT
74.8 x 12.1 x 53.3 mm
