johnharveybc/Robert-roving-robot/Mechanical Stuff/Balsa Shaft.SLDPRT

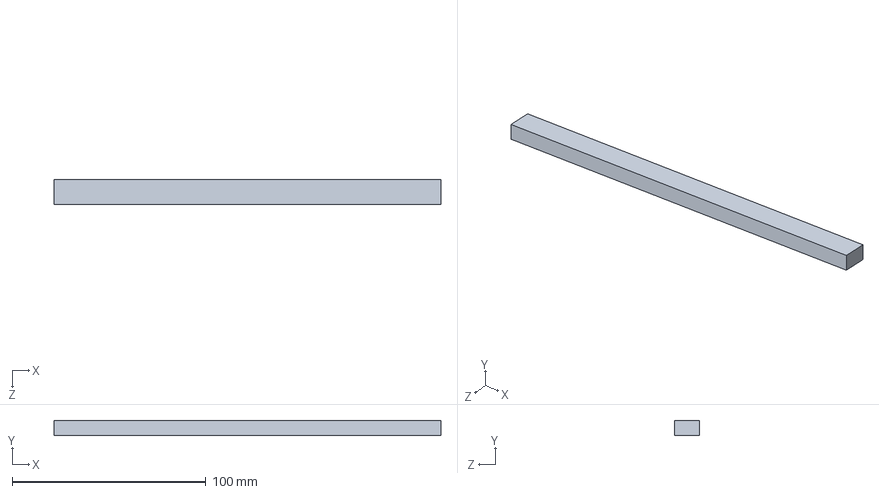
[picture p28: CAD file, 2014-02-28]
Mechanical Stuff/Balsa Shaft.SLDPRT
200.0 x 8.00 x 12.7 mm
