johnharveybc/Robert-roving-robot/Mechanical Stuff/Motor.SLDPRT

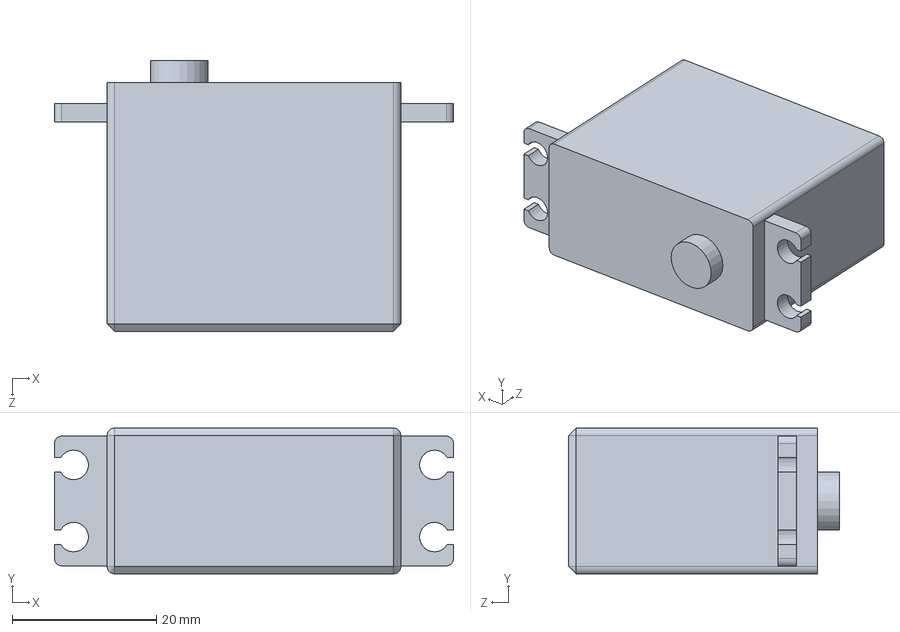
[picture p29: CAD file, 2014-02-28]
Mechanical Stuff/Motor.SLDPRT
55.3 x 20.2 x 37.5 mm
