johnharveybc/Robert-roving-robot/Report/Robot Pictures/Partial Assembly.jpg

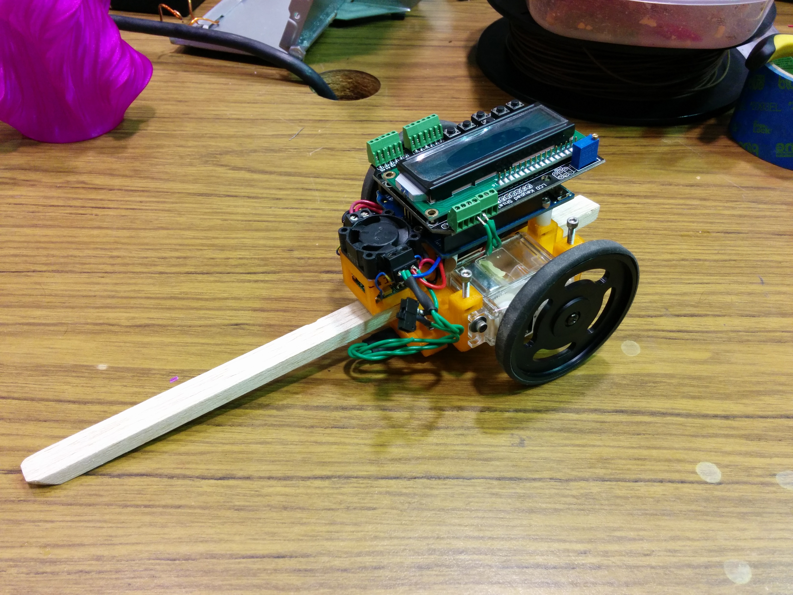
Report/Robot Pictures/Partial Assembly.jpg
