johnharveybc/Robert-roving-robot/(commit log)

2014-02-27 Added all current Mech. stuff
    The .gitignore file will prevent those pesky temporary solidworks files
    from getting committed.
    [Arduino UNO.SLDPRT, Battery Holder.SLDPRT, Chassis.SLDPRT, Main Assembly.SLDASM]
2014-02-27 Balsa Shaft added
    [Arduino UNO.SLDPRT, Balsa Shaft.SLDPRT, Battery Holder.SLDPRT, Main Assembly.SLDASM]
2014-02-27 Revert "Balsa Shaft added"
    This reverts commit 855d58258e56461e045043437aeba678e738b3ff.
    [Arduino UNO.SLDPRT, Balsa Shaft.SLDPRT, Battery Holder.SLDPRT, Main Assembly.SLDASM]
2014-02-27 Sensor Head init
    [Sensor Head.SLDPRT]
2014-02-28 SH update
    [Sensor Head.SLDPRT]
2014-02-28 Motor added, balsa shaft re-added
    [Balsa Shaft.SLDPRT, Motor.SLDPRT]
2014-02-28 Assembled assembly, semi-final Chassis
    [Arduino UNO.SLDPRT, Battery Holder.SLDPRT, Chassis.SLDPRT, Main Assembly.SLDASM]
2014-02-28 Added EM shield plate
    [Main Assembly.SLDASM, Shield Plate.SLDPRT]
2014-03-05 Adjustable inductor position
    [Sensor Head.SLDPRT]
2014-03-09 Added sensor circuit mount-points to chassis
    [Chassis.SLDPRT, Main Assembly.SLDASM, Sensor Circuit Box.SLDPRT, Shield Plate.SLDPRT]
2014-03-13 Added Sauce Case and Print-Tolerances Test Part
    [Sauce Case.SLDPRT, Tolerances Test Part.SLDPRT]
2014-03-13 Updated Chassis to final_v1
    [Chassis.SLDPRT]
2014-03-25 Motor speed off in menu
2014-03-26 Improved state handling. Added battery voltage readings
2014-03-26 Center sensor values
2014-03-26 intersections + analog PID + a pony
2014-03-28 Added new sensor and circuit mounts
    ... and a pony?
    [Centre Sensor Mount.SLDPRT, Circuit Mount.SLDPRT]
2014-03-28 Actual sensor head
    [Sensor head 3.SLDPRT]
2014-03-28 Added debug state and simple run timer
2014-03-28 Turn signal indicators and simple timer
2014-03-31 Correct timing and tuned code
    [Wire following PID control.cpp]
2014-04-07 Report update
    To-do:
    MOSFET driver diagram
    Value of amplifier gain
    Code section
    Code block diagrams
    Testing of each block? Seems useless, probably not going to happen
    Review by teammembers
